warasugitewara/useless-box/README.md

<div align="center">

# 🎁 useless-box

### スイッチを押すと、フタが開き、腕が出てきて、スイッチを押し戻す。<br>それだけの箱。

#### ……しかも R/C で走り回る。

<br>











<br>

**[概要](#-概要)** ・ **[設計判断](#-設計判断ログ)** ・ **[回路](#-回路)** ・ **[表示部](#-表示部)** ・ **[バリエーション](#-バリエーション)** ・ **[コード](#-コード設計)** ・ **[R/C](#️-rc-クローラー)** ・ **[TODO](#-todo)**

<sub>課題研究作品</sub>

</div>

---

## 📖 概要

いわゆる **Useless Box / Useless Machine** の Arduino 実装です。
押されたら押し返す、ただそれだけの動作を **5種類の性格** で演じ分けます。

```
 押す  →  📦 フタが開く  →  🦾 腕が出る  →  👆 押し返す  →  📦 閉じる  →  ↺
```

さらにこの箱は **クローラー（無限軌道）を履いて R/C で走ります。**
押しに行かないと押し返してもらえない箱、という無駄の上積みです。

### システム構成

本機は**2つの独立したシステム**で構成されています。

| | 🎁 本体（Useless Box） | 🕹️ R/C クローラー |
|:--|:--|:--|
| **マイコン** | Arduino UNO 3 | Freenove ESP32 × 2 |
| **役割** | 押し返す動作・表示 | 無線操縦での走行 |
| **電源** | 単三×3（4.5V）＋ 単三×4（6.0V） | 独立（ESP32・モーターで別系統） |
| **ドキュメント** | このページ | [`rc/README.md`](rc/README.md) |

> [!IMPORTANT]
> **2つは電気的に完全に分離されています。** ブラシ付きDCモーターは強いノイズ源で、
> 電源やGNDを共有するとサーボの誤動作やスピーカーノイズの原因になります。
> 統合せず切り離すことで、本体は2電源構成のまま維持でき、制御ピンも一切消費しません。

### 本体のスペック

| | |
|:--|:--|
| **マイコン** | Arduino UNO 3 |
| **アクチュエータ** | SG90（フタ）／ MG996R（腕） |
| **表示** | 7セグLED 2桁（74HC595 ×2 カスケード） |
| **電源** | 単三×3（4.5V）＋ 単三×4（6.0V）の2系統 |
| **実装** | はんだ付け＋ホットボンドのクイックリリース空中配線 |

---

## 🧭 設計判断ログ

作りながら踏んだ問題と、その解決の記録です。**このプロジェクトの本体はここ**かもしれません。

| # | 起きた問題 | 原因 | 採った対策 |
|:-:|:---|:-----|:---|
| 1 | 動作の途中で Arduino がリセットする | MG996R の突入電流（最大 **2.5A**）で電源電圧が降下 | 電源系統を **2系統に分離**＋ 470µF×2 を MG996R 根本に並列 |
| 2 | 電源を入れ直すと毎回同じ順序で動く | `randomSeed()` 未設定で疑似乱数列が固定 | 未接続ピン `A0` の**浮遊ノイズ**をシードに使用 |
| 3 | 同じ演出が2回続いて興ざめする | 単純な `random()` は連続を許す | 直前の値を保持して **一致したら再抽選** |
| 4 | 待機中にサーボが発熱し、うなり音が出る | 保持トルクが常時かかっている | アイドル時に `detach()` で**脱力**（フタは縁掛かり構造で位置を維持） |
| 5 | 7セグ2桁を直結するとピンが足りない | 2桁分で最大 14本のセグメント線が必要 | **74HC595 ×2 カスケード**で Arduino 側は **3ピン**に圧縮 |
| 6 | ダイナミック点灯だと表示が破綻する | 本体が `delay()` ブロッキング設計でリフレッシュを回せない | **スタティック点灯**（桁ごとに595を専有）へ切り替え |

---

## ⚡ 回路

<div align="center">
回路図
</div>

### 部品構成

| パーツ | 型番 | 電源系統 | 役割 | ピン |
|:---|:-----|:---:|:-----|:----:|
| マイコン | Arduino UNO 3 | 🔴 A | 制御 | — |
| サーボ（フタ） | SG90 | 🔴 A | フタの開閉 | `D5` |
| サーボ（腕） | MG996R | 🟢 B | スイッチを押す腕 | `D6` |
| スイッチ | — | — | トリガー入力 | `D12` |
| 7セグLED | PARA LIGHT A-552SRD | 🔴 A | case番号・押下回数の表示 | — |
| シフトレジスタ | UTC U74HC595A × 2 | 🔴 A | 7セグ駆動（カスケード） | `D2` `D3` `D4` |
| 電源A | 単三電池 × 3本（4.5V） | — | Arduino・SG90・表示部 | — |
| 電源B | 単三電池 × 4本（6.0V） | — | MG996R 専用 | — |
| コンデンサ | 470µF × 2（並列） | 🟢 B | 起動スパイク吸収 | MG996R 根本 |

### ピン割り当て

既存の駆動系を最優先で固定し、後付けの表示部を空きピンへ寄せています。

| ピン | 用途 | 区分 |
|:----:|:-----|:----:|
| `D2` `D3` `D4` | 74HC595（DS / SH_CP / ST_CP） | 表示 |
| `D5` | SG90（フタ） | 駆動 |
| `D6` | MG996R（腕） | 駆動 |
| `D7` `D8` `D9` `D13` | **空き** | — |
| `D10` `D11` | DFPlayer Mini 用に**予約** | 予約 |
| `D12` | トリガースイッチ | 駆動 |
| `A0` | randomSeed 用（**未接続を維持**） | 制御 |

<details>
<summary><b>🔋 なぜ2電源に分離したのか</b></summary>

<br>

MG996R は起動時に **最大 2.5A** を引き込みます。単一電源だとこの瞬間に電圧が降下し、
Arduino がブラウンアウトリセットしてしまい、動作が途中で最初からやり直しになりました。

| 系統 | 電池 | 電圧 | 給電対象 |
|:----:|:-----|:----:|:---|
| 🔴 A | 単三 × 3 | 4.5V | Arduino UNO 3・SG90・表示部 |
| 🟢 B | 単三 × 4 | 6.0V | MG996R のみ |

電源を分けることで、MG996R の突入電流が制御系の電圧に影響しなくなります。
6.0V は MG996R の定格範囲（4.8〜7.2V）に収まっており、4.8V 時より動作も速くなります。

コンデンサ（470µF × 2 並列 = 940µF）は MG996R の VCC・GND 根本に直接付け、
突入電流のピークを吸収させています。

> [!WARNING]
> **電池A・BのGNDは必ず共通接続すること。**
> `D6` の信号は Arduino 側の GND を基準にした電圧なので、
> MG996R 側の GND が繋がっていないと基準電位が定まらず誤動作します。

</details>

<details>
<summary><b>🔧 実装メモ（クイックリリース構成）</b></summary>

<br>

- 配線はすべて**はんだ付け＋ホットボンド固定**。基板は使っていません
- 構成変更（2電源化・7セグ追加など）が頻繁に入る試作段階では、
  基板を引き直すより空中配線＋コネクタのほうが手戻りが少ないという判断です
- ブレッドボードを使わないのは、サーボの振動で接触不良を起こしやすいため
- `A0` ピンは**何も接続しない**こと（浮遊ノイズをランダムシードに使うため）

</details>

---

## 🔢 表示部

<div align="center">
7セグ表示部の配線
</div>

動作中は実行中の **case 番号**、待機中は通算の **押下回数**（00〜99）を表示します。

> [!IMPORTANT]
> **両ICの固定配線を忘れないこと。** コードに現れないため見落としがちです。
> `OE(13) → GND` ／ `SRCLR(10) → 5V` ／ `VCC(16) → 5V` ／ `GND(8) → GND`
> さらに `IC1 の QH'(9) → IC2 の DS(14)` がカスケード線になります。

<details>
<summary><b>💡 スタティック点灯を選んだ理由</b></summary>

<br>

本スケッチは `delay()` によるブロッキング設計です。
ダイナミック点灯（1個の595で両桁を高速に切り替える方式）は動作中もリフレッシュを
回し続ける必要があるため、`delay(650)` などで停止している間に表示が破綻します。

そこで **595 を1個ずつ各桁に専有させるスタティック点灯**を採用しました。
ラッチした表示は次に書き換えるまで保持されるので、ブロッキング中も表示が消えません。

非同期化して `millis()` ベースに書き直せばダイナミック点灯も可能ですが、
本用途では並行処理が不要なため、複雑さに見合いません。

</details>

<details>
<summary><b>🔀 ビット順とカスケードの送出順</b></summary>

<br>

74HC595 は「**最初に送ったビットが QH まで押し出される**」構造です。
したがって `MSBFIRST` では bit0 が最後に出て QA に残り、次のように対応します。

```
bit0=a, bit1=b, bit2=c, bit3=d, bit4=e, bit5=f, bit6=g, bit7=dp
```

```cpp
const byte digits[10] = {
  0b00111111, // 0
  0b00000110, // 1
  // …
};
```

カスケードでも同じ理屈が働きます。

```cpp
void writeDigits(byte segLeft, byte segRight) {
  digitalWrite(latchPin, LOW);
  shiftOut(dataPin, clockPin, MSBFIRST, ~segLeft);   // 先に送る → 奥のIC2（十の位）
  shiftOut(dataPin, clockPin, MSBFIRST, ~segRight);  // 後に送る → 手前のIC1（一の位）
  digitalWrite(latchPin, HIGH);
}
```

**先に送ったバイトが奥のICへ押し出され、後に送ったバイトが手前のICに留まります。**
直感と逆なので注意。左右が入れ替わって表示された場合はこの2行を交換してください。

`~` によるビット反転は A-552SRD が **アノードコモン**だからです。
コモン側が＋なので、595 の出力が **LOW のときに点灯**します。

</details>

<details>
<summary><b>⚡ 電流設計</b></summary>

<br>

74HC595 は **1ピン ±35mA・チップ合計 ±70mA** が上限です。
桁ごとに595を分けているため、1チップが受け持つのは最大7セグメントに収まります。

| 抵抗 | 1セグメント電流 | `8` 表示時の1チップ合計 | 判定 |
|:----:|:---:|:---:|:----:|
| 470Ω | 約 5mA | 約 35mA | ✅ 余裕あり |
| 330Ω | 約 7mA | 約 50mA | ✅ 明るくしたい場合 |
| 220Ω | 約 11mA | 約 77mA | ❌ 合計上限を超える |

</details>

---

## 🎭 バリエーション

<div align="center">
バリエーション一覧
</div>

| Case | 性格 | 演出 |
|:----:|:-----|:-----|
| 1️⃣ | **ノーマル** | 迷わずスパッと処理する仕事人 |
| 2️⃣ | **ためらいがち** | 半開き → 引き戻し → 諦めて全開 |
| 3️⃣ | **即ブチ切れ** | 全力最速で反応 |
| 4️⃣ | **フェイント2連** | 2回チラ見せしてから本番 |
| 5️⃣ | **連続ノック** | 腕を2回叩きつける激おこ |

電源投入ごとに `randomSeed(analogRead(A0))` でシードが変わるため毎回異なる順序になり、
さらに直前と同じ case を引いた場合は再抽選して同一演出の連続を避けています。

---

## 💻 コード設計

### 角度と待機時間

```cpp
const int lidClosed    = 90;   // フタが閉まる角度
const int lidOpen      = 3;    // フタが開く角度
const int armRetracted = 3;    // 腕が格納された角度
const int armExtended  = 110;  // 腕が伸びた角度

const int LID_MOVE_MS = 200;   // SG90   : 90° 動ききる余裕時間
const int ARM_MOVE_MS = 420;   // MG996R : 110° 動ききる余裕時間
```

待機時間はカタログ値から逆算して決めています。ここを削ると、
サーボが動ききる前に次の指示が飛んで動作が破綻します。

| サーボ | カタログ速度 | 実必要時間 | 設定値 |
|:---|:---:|:---:|:---:|
| SG90（フタ 90°） | 0.1s/60° | ≈150ms | 200ms |
| MG996R（腕 110°） | 0.17s/60° @4.8V | ≈311ms | 420ms |

> [!TIP]
> 6V 給電では MG996R は約 0.13s/60° に速くなるため、`ARM_MOVE_MS` は
> 実機確認のうえ 300ms 前後まで詰められる可能性があります。

<details>
<summary><b>🎬 sweep() — 演技のコア</b></summary>

<br>

```cpp
void sweep(Servo &s, int from, int to, int stepDelay) {
  int step = (from < to) ? 1 : -1;
  for (int pos = from; pos != to + step; pos += step) {
    s.write(pos);
    delay(stepDelay);
  }
}
```

SG90 を 1° ずつ動かすことで「ためらい」「フェイント」を表現します。
`stepDelay` が演技の速度そのものになります。

| stepDelay | 90°あたり | 印象 |
|:---:|:---:|:-----|
| 6 ms/度 | 約 540ms | 素早いフェイント |
| 10 ms/度 | 約 900ms | 標準 |
| 15 ms/度 | 約 1350ms | ためらい・逡巡 |

MG996R はトルクが強く途中停止が不安定なため、`write()` 直接制御のみを使用しています。

</details>

<details>
<summary><b>😴 アイドル時のサーボ切り離し</b></summary>

<br>

```cpp
#define IDLE_DETACH 1
```

待機中はサーボを `detach()` して脱力させ、無駄な発熱と電力消費を抑えています。

これが成立するのは、**フタが縁に引っかかる構造**で脱力しても位置がずれないためです。
また Servo ライブラリは `attach()` 時に前回の `write()` 値でパルスを再開するので、
復帰時に勝手に動く（ジャンプする）こともありません。

自重でずれる構造に変更した場合は `0` にして常時保持へ切り替えてください。

</details>

<details>
<summary><b>🔘 スイッチデバウンス</b></summary>

<br>

物理スイッチは押した瞬間に接点がバウンドし、数ミリ秒間 ON/OFF を高速に繰り返します
（チャタリング）。`loop()` は毎秒数万回まわるので、対策しないと1回の押下が
複数回の起動として検出されます。

```
理想:  ____/￣￣￣￣￣￣
現実:  ____/\/\/\/￣￣￣￣
            ↑ ここを無視したい
```

本機では二段構えで抑止しています。

1. 検出時に **20ms 待って再確認**（振動などによる誤検出を除去）
2. 動作シーケンス末尾に **`delay(100)`**（押し戻し時のバウンドを吸収）

</details>

---

## 🕹️ R/C クローラー

箱を走らせる走行機構は、**本体とは独立したプロジェクト**として [`rc/`](rc/) にあります。

```
[送信機]  ESP32 + ジョイスティック
              │
              │  ESP-NOW（ルーター不要・低遅延）
              ▼
[車体]    ESP32 + TA7291P ×2 + クローラー
```

| 項目 | 内容 |
|:-----|:-----|
| マイコン | Freenove ESP32 開発ボード × 2 |
| 通信 | **ESP-NOW** — ルーターを介さず直接通信 |
| 操作部 | ジョイスティックを配線した自作コントローラ |
| モータードライバ | TOSHIBA **TA7291P** × 2 |
| 状態 | 設計中（実装未着手） |

構成・配線・実装時の注意点（16項目）は **[`rc/README.md`](rc/README.md)** にまとめてあります。

---

## 🚧 TODO

- [ ] **🔊 サウンド再生 — DFPlayer Mini**（7seg との統合テスト成功・本体組み込み待ち）
  - モジュール: DFPlayer Mini HW-247A（チップ **TD5580A**）＋ 8Ω 2W スピーカー
  - **単体テスト完了** → [`test/dfplayer/`](test/dfplayer/)。`playMp3Folder()` 方式（`/mp3/000x.mp3`）で再生確認
  - **7seg との統合テスト成功** → [`test/integration/`](test/integration/)。Nano 上で表示＋再生の同時動作を確認
  - 音声: case ごとに `0001.mp3`〜`0005.mp3` を割り当て（5はミーム）。再生タイミングは動作の頭
  - 接続: `D10`(DFのTX) / `D11`(DFのRX・1kΩ直列) / VCC は電源A
  - **本体統合コードはローカルに作成済み**。実機での音出し・動作重なり確認をしてから push 予定
  - 次の作業対象。Nano移行と 7セグ・DFP の本体組み込みをまとめて進める
  - パスコン追加（鳴らしてノイズが出たら）: DFPlayer VCC-GND 直近に 100µF電解 + 0.1µFセラミック
  - ノイズ評価 → パスコン有無の比較（研究レポート題材）

- [ ] **🔌 Arduino Nano への移行**（次に着手予定）
  - 本体マイコンを UNO R3 → **Nano 互換機（CH340C・Type-C）** に載せ替え
  - 理由: 基板が小さく箱に収めやすい／Type-C で抜き差しが楽／在庫に余裕（Nano ×4）
  - コードは互換（同 ATmega328P・同ピン番号）なのでそのまま動く。7seg+DFP 統合テストも Nano で成功
  - ⚠️ 書き込み時は **ツール → プロセッサ → 「ATmega328P (Old Bootloader)」** を選ぶこと（デフォルトだと `not in sync resp=0x00` で書き込めない）
  - 注意: Nano の A6/A7 は**アナログ入力専用**（`digitalWrite` 不可）。増えた2本はシード源や入力用に活用可
  - 7セグ（74HC595）と DFPlayer の本体統合を、この移行と同じタイミングで実施する
  - 統合コードはローカルに作成済み → 実機確認して問題なければ push

- [ ] **🦾 腕の自作パーツ** — FreeCAD でパラメトリック設計中

- [ ] **プリント基板化（本体統合ボード）** — [`pcb/`](pcb/) で設計中。Nano・595×2・DFP・抵抗を1枚に、サーボ/スイッチ/7seg/2電源は端子で外出し。片面エッチング・ベタGND。PCBE 清書 → エッチング予定

<details>
<summary><b>🧰 手持ちマイコン在庫（役割分担）</b></summary>

<br>

| ボード | 枚数 | 用途 |
|:---|:----:|:-----|
| Arduino UNO R3 | 10 | 据え置き実験・予備 |
| Arduino Nano 互換（CH340C / Type-C） | 4 | **本体（意味のない箱）組み込み用** |
| ESP32-WROOM-32E 開発ボード（技適取得済み） | 4 | R/C クローラー（送信・受信＋予備） |

R/C クローラーはペアが担当。本リポジトリでは本体（Nano）側の実装を進める。

</details>

---

## 📂 ファイル構成

```
useless-box/
├── useless_box.ino      # メインスケッチ
├── test/
│   ├── 7seg/            # 7セグ単体テスト（00〜99 カウントアップ）
│   │   ├── count.ino
│   │   ├── README.md
│   │   └── seg7_breadboard.jpg
│   ├── dfplayer/        # DFPlayer 単体テスト
│   │   ├── dfplayer_test.ino
│   │   ├── README.md
│   │   └── dfplayer_breadboard.jpg
│   └── integration/    # 7seg + DFPlayer 統合テスト
│       ├── integ_7seg_dfp_test.ino
│       ├── README.md
│       └── integration_breadboard.jpg
├── pcb/                 # 本体統合ボード設計（PCBE・片面エッチング）
│   ├── README.md
│   └── wiring.md        # ピンtoピン結線リスト
├── rc/                  # R/C クローラー（独立系統・ESP32）
│   ├── README.md
│   └── crawler_rc.ino   # 送信機・受信機 兼用（未実装）
├── docs/
│   ├── circuit.svg      # 回路図（全体）
│   ├── display.svg      # 7セグ表示部の詳細結線
│   └── variations.svg   # バリエーション タイムライン
└── README.md
```

> [!NOTE]
> `test/7seg/count.ino` は表示部の単体検証用で、ピン割り当てが本体と異なります
> （`D8`=ST_CP / `D12`=SH_CP / `D11`=DS）。本体へ移行する際は信号線3本を
> `D2`/`D3`/`D4` へ挿し替えてください。595側の固定配線は変更不要です。
> 各テストの詳細と配線写真は [`test/7seg/`](test/7seg/) ・ [`test/dfplayer/`](test/dfplayer/) を参照。

---

## ⚠️ 注意事項

| | |
|:--|:--|
| **MG996R の動作電圧** | 4.8〜7.2V（電源Bの 6.0V は範囲内） |
| **MG996R の突入電流** | 最大 2.5A — 電源系統の分離が必須 |
| **74HC595 の出力上限** | チップ合計 ±70mA — セグメント抵抗を 330Ω より小さくしないこと |
| **GND 共通** | 電池A・B の GND は必ず繋ぐこと |
| **`A0` ピン** | 何も接続しない（ランダムシード用） |

---

<div align="center">

## ✍ ライセンス

**MIT**

</div>
