warasugitewara/useless-box/pcb/wiring.md

# useless-box 本体統合ボード ピンtoピン結線リスト

表示部(DFP+595×2+7seg抵抗) に **本体(Nano・サーボ・スイッチ・2電源)** を統合した完全版。

1行 = 配線1本。PCBEで引くたび ☐→☑。R/Cクローラーは別基板（含まない）。

> [!IMPORTANT]
> **次回の変更予定: D11 と D12 を入れ替える**（配線の都合）
> - 変更後: `D11 = トリガースイッチ` / `D12 = DFPlayer RX(1kΩ経由)`
> - この結線リストの該当行（B項の D11/D12、F項・G項）を書き換えること
> - **コード `useless_box.ino` のピン定義も同時に修正**（配線とコードは一致必須）
>   - `switchPin` を 11 へ / DFPの SoftwareSerial RX側(TX from Nano) を 12 へ

## 電源系統（重要）

- **電源A 4.5V**: Nano(5V/VIN)・7seg系(595/DFP/7segコモン)
- **電源B 6.0V**: MG996R専用。**電源B端子→サーボ端子へ直行**（Nano/信号系を通さない）
- **GND**: ベタGNDで全系統共通（電源A・B・信号すべて）。6V経路のGNDは太めに確保
- SG90(フタ)は電源A(4.5V)側、MG996R(腕)は電源B(6V)側

略号: 595#1=右桁 595#2=左桁 / DFP=DFPlayer / 7seg=A-552SRD / SV=サーボ / SW=スイッチ

7segピン: DIG.1→a16 b15 c3 d2 e1 f18 g17 dp4 com14 / DIG.2→a11 b10 c8 d6 e5 f12 g7 dp9 com13

## A. 電源入力（端子台）と分配

| ☐ | 起点 | → | 終点 | 備考 |
|:-:|:-----|:-:|:-----|:-----|
| ☐ | 電源A端子 +4.5V | → | Nano 5V(または VIN) | Nano給電 |
| ☐ | 電源A端子 +4.5V | → | 595#1 16(VCC) | 表示系5V |
| ☐ | 電源A端子 +4.5V | → | 595#2 16(VCC) |  |
| ☐ | 電源A端子 +4.5V | → | 595#1 10(SRCLR) |  |
| ☐ | 電源A端子 +4.5V | → | 595#2 10(SRCLR) |  |
| ☐ | 電源A端子 +4.5V | → | DFP 1(VCC) |  |
| ☐ | 電源A端子 +4.5V | → | 7seg com14(DIG.1) | アノードコモン |
| ☐ | 電源A端子 +4.5V | → | 7seg com13(DIG.2) |  |
| ☐ | 電源A端子 +4.5V | → | SVフタ端子 +(SG90赤) | SG90電源(4.5V) |
| ☐ | 電源A端子 GND | → | ベタGND | A系GND |
| ☐ | 電源B端子 +6V | → | SV腕端子 +(MG996R赤) | ★6V直行・太線 |
| ☐ | 電源B端子 GND | → | ベタGND | ★B系GND・太線・A系と共通 |

## B. Nano ↔ 各機能（信号線）

| ☐ | Nanoピン | → | 終点 | 備考 |
|:-:|:---:|:-:|:-----|:-----|
| ☐ | D2 | → | 595#1 14(SER) | 7segデータ |
| ☐ | D3 | → | 595#1 11 & 595#2 11(SRCLK) | クロック共通(ジャンパー候補) |
| ☐ | D4 | → | 595#1 12 & 595#2 12(RCLK) | ラッチ共通(ジャンパー候補) |
| ☐ | D5 | → | SVフタ端子 信号(SG90橙) | フタ サーボ信号 |
| ☐ | D6 | → | SV腕端子 信号(MG996R橙) | 腕 サーボ信号 |
| ☐ | D10 | → | DFP 3(TX) | DFP→Nano |
| ☐ | D11 | → | R17→DFP 2(RX) | 1kΩ保護経由 |
| ☐ | D12 | → | SW端子 片側 | スイッチ(内部プルアップ) |
| ☐ | GND | → | ベタGND | Nano GND |
| ☐ | A0 | → | 未接続 | randomSeed用・浮かせる |

## C. 595 固定配線・カスケード

| ☑ | 起点 | → | 終点 | 備考 |
|:-:|:-----|:-:|:-----|:-----|
| ☑ | 595#1 8(GND) | → | ベタGND |  |
| ☑ | 595#2 8(GND) | → | ベタGND |  |
| ☑ | 595#1 13(OE) | → | ベタGND |  |
| ☑ | 595#2 13(OE) | → | ベタGND |  |
| ☑ | 595#1 9(QH') | → | 595#2 14(SER) | カスケード(ジャンパー候補) |

## D. 595#1(右桁 DIG.2) 出力→抵抗→7seg

| ☐ | 595#1出力 | → | 抵抗 | → | 7seg(DIG.2) |
|:-:|:---|:-:|:-----|:-:|:---|
| ☐ | 595#1 15(QA) | → | R1 | → | 7seg a11 |
| ☐ | 595#1 1(QB) | → | R2 | → | 7seg b10 |
| ☐ | 595#1 2(QC) | → | R3 | → | 7seg c8 |
| ☐ | 595#1 3(QD) | → | R4 | → | 7seg d6 |
| ☐ | 595#1 4(QE) | → | R5 | → | 7seg e5 |
| ☐ | 595#1 5(QF) | → | R6 | → | 7seg f12 |
| ☐ | 595#1 6(QG) | → | R7 | → | 7seg g7 |
| ☐ | 595#1 7(QH) | → | R8 | → | 7seg dp9 |

## E. 595#2(左桁 DIG.1) 出力→抵抗→7seg

| ☐ | 595#2出力 | → | 抵抗 | → | 7seg(DIG.1) |
|:-:|:---|:-:|:-----|:-:|:---|
| ☐ | 595#2 15(QA) | → | R9 | → | 7seg a16 |
| ☐ | 595#2 1(QB) | → | R10 | → | 7seg b15 |
| ☐ | 595#2 2(QC) | → | R11 | → | 7seg c3 |
| ☐ | 595#2 3(QD) | → | R12 | → | 7seg d2 |
| ☐ | 595#2 4(QE) | → | R13 | → | 7seg e1 |
| ☐ | 595#2 5(QF) | → | R14 | → | 7seg f18 |
| ☐ | 595#2 6(QG) | → | R15 | → | 7seg g17 |
| ☐ | 595#2 7(QH) | → | R16 | → | 7seg dp4 |

## F. DFPlayer

| ☑ | 起点 | → | 終点 | 備考 |
|:-:|:-----|:-:|:-----|:-----|
| ☑ | R17 片脚 | → | Nano D11 | 1kΩ保護 |
| ☑ | R17 もう片脚 | → | DFP 2(RX) |  |
| ☑ | DFP 6(SPK1) | → | SPK端子1 | スピーカー |
| ☑ | DFP 8(SPK2) | → | SPK端子2 | GNDに繋がない |
| ☑ | DFP 7(GND) | → | ベタGND |  |

## G. スイッチ端子

| ☐ | 起点 | → | 終点 | 備考 |
|:-:|:-----|:-:|:-----|:-----|
| ☐ | SW端子 片側 | → | Nano D12 | 内部プルアップ使用 |
| ☐ | SW端子 もう片側 | → | ベタGND | 押すとLOW |

## 外部へ出る端子まとめ

| 端子 | ピン数 | 内容 |
|:-----|:---:|:-----|
| 電源A | 2 | +4.5V / GND |
| 電源B | 2 | +6V / GND |
| 7seg | 18 | セグ16＋コモン2 |
| SVフタ(SG90) | 3 | +4.5V / 信号 / GND |
| SV腕(MG996R) | 3 | +6V / 信号 / GND |
| スイッチ | 2 | 信号 / GND |
| スピーカー | 2 | SPK1 / SPK2 |

## 基板に載る部品

- Arduino Nano（ピンソケットに挿す）
- 74HC595 × 2
- DFPlayer Mini HW-247A（直付け）
- 抵抗 470Ω × 16（R1〜R16）+ 1kΩ × 1（R17）
- 各端子（端子台/ピンヘッダ）

## 設計上の要点（過去の教訓を反映）

- **6V(MG996R)は電源Bからサーボ端子へ直行**。Nano・信号系を通さない → ブラウンアウト回避
- **電源A・BのGNDはベタGNDで共通**（別々だとMG996R誤動作）
- 6V経路（電源B+とGND）は突入電流2.5A対応で**太いパターン**にする
- SG90は4.5V側、MG996Rは6V側で系統が違うので端子で分ける
