warasugitewara/useless-box/(list of files, drawings)

Other design files:
pcb/7seg.pcb
