warasugitewara/useless-box/(commit log)

2026-06-10 Add useless_box.ino: lid angle fix + randomSeed
    [useless_box.ino]
2026-06-10 Add circuit diagram SVG
2026-06-11 Fix: move capacitor outside bus lines to avoid overlap
2026-06-24 Update circuit: dual power supply (4.5V for Arduino+SG90, 6V for MG996R)
2026-06-24 Update README: dual power supply configuration
2026-06-24 Fix circuit.svg: all wires orthogonal, signal routes left of buses
2026-06-25 Add reviewed/improved useless_box variant (fix version)
    - DRY: extract openLid/closeLid/poke helpers
    - Differentiate Case 3 as genuine fastest action (was identical to Case 1)
    - Detach servos while idle to cut buzzing/current/jitter (IDLE_DETACH toggle)
    - Name magic angles (lidPeek/lidFeint1/lidFeint2)
    - Avoid repeating the same variation consecutively
    - Add entry-side switch debounce
    Claude-Session: https://claude.ai/code/session_01Re98Uv9YUuD7TXYUUDhUKf
2026-06-25 Document switch logic inversion (reversed-mount workaround)
    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
2026-07-08 Promote improved version (fix/) to root useless_box.ino
    [useless_box.ino]
2026-07-08 Add power supply voltage details in README
2026-07-08 Add TODO section: DFPlayer sound + case display module
2026-07-22 Add test/count.ino: 2-digit 7seg counter test (fix segment pattern for '7')
    [count.ino]
2026-07-22 Add display.svg: 7seg + 74HC595 cascade wiring
2026-07-22 Fix circuit.svg: add 7seg display block, reorder blocks by pin order, fix 6V line crossing through Arduino
2026-07-22 README: match new circuit.svg width
2026-07-22 README: document caterpillar RC plan (ESP32 + ESP-NOW + TA7291P) as separate project
2026-08-26 README TODO: add Nano migration + 7seg/DFP integration as next task, board inventory note
2026-09-09 Integration test: add 5 physical switches (D7-D9,D12,D13)
2026-09-09 Integration test: add 5 physical trigger switches with edge detection
2026-09-16 Add PCB design directory (single-sided etching, ground plane)
2026-09-16 Add netlist for display board
2026-09-16 Add coordinate table for PCBE placement
2026-09-16 README: add pcb/ directory to file tree and TODO
2026-09-16 Add full integrated wiring list (Nano/servo/switch/dual-power)
2026-09-16 Update PCB README for full body integration
2026-09-16 Remove old display-only netlist (merged into wiring.md)
2026-09-16 Remove placement layout (placement decided in PCBE)
2026-09-16 README: pcb/ now full body integration board
2026-09-16 wiring: note to swap D11/D12 next time (wiring convenience)
2026-09-16 Update wiring status from unchecked to checked
2026-10-07 pcb: 7seg部のPCBEデータとスクショを追加
    ランドをパターン-Aへ移し、パターン-Aのみの印刷で配線とランドが出るようにした。
    右桁のd/f入れ替わりはコード側で補正する旨をREADMEに記載。
    Claude-Session: https://claude.ai/code/session_01Jaa4paeMSwMYfPyVRtzEsk
    [7seg.pcb]
2026-11-11 本体: MG996R×2 化と動き×音の25通り、テスト用スケッチを追加
    - フタのサーボを SG90 から MG996R に変更（LID_MOVE_MS 300ms / LID_FAST_MS 260ms）
    - 動きと音を別々に抽選して全25通りに。7seg に組み合わせ番号（01〜25）を表示
    - 音5（ミーム音声）は重み付き抽選で約1%
    - シリアルから 1〜5 で動作を強制実行できる確認用機能
    - PIN_LAYOUT_PCB で基板の D11/D12 入れ替えに対応
    - 7seg 基板の d/f 入れ替えをコードで補正（PCB_DIG2_DF_SWAP）
    - test/pcb_7seg_test・test/mg996r_dual_test を追加
    - 箱（木製）完成後に角度と待機時間の調整が必要
2026-11-11 配線資料と回路図をフタの MG996R 化に合わせて更新
    - pcb/wiring.md: フタのサーボ端子の＋を電源A(4.5V)から電源B(6V)へ。SG90 表記を MG996R に
    - pcb/README.md: 端子・電源設計・ピン割り当ての SG90 表記を MG996R に、電源Bは MG996R×2 専用に
    - docs/circuit.svg: フタのサーボを 6V 系につなぎ替え、表記を MG996R・Arduino Nano に
    - docs/variations.svg: 凡例のフタを MG996R に
