warasugitewara/useless-box/(notices)

Notices in the files:
README.md:
License: MIT
